laas/HRP2_Batterry_monitor/wiring.png

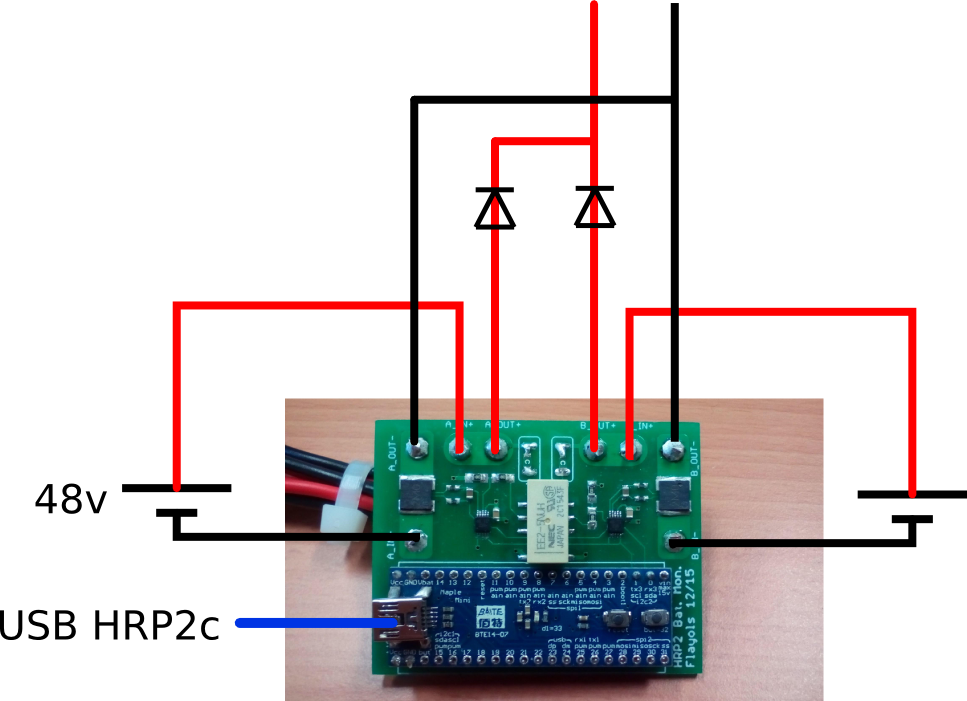
wiring.png
