laas/HRP2_Batterry_monitor/README.md

# HRP2_Battery_monitor
[BOARD] measure voltage and current of each of the 2 batteries of HRP2 via INA226
