laas/HRP2_Batterry_monitor/HARDWARE_HRP2_BATTERY_MONITOR/Battery_monitor_HRP2/Battery_board.brd

## EAGLE design HARDWARE_HRP2_BATTERY_MONITOR/Battery_monitor_HRP2/Battery_board.brd (2016-01-18)

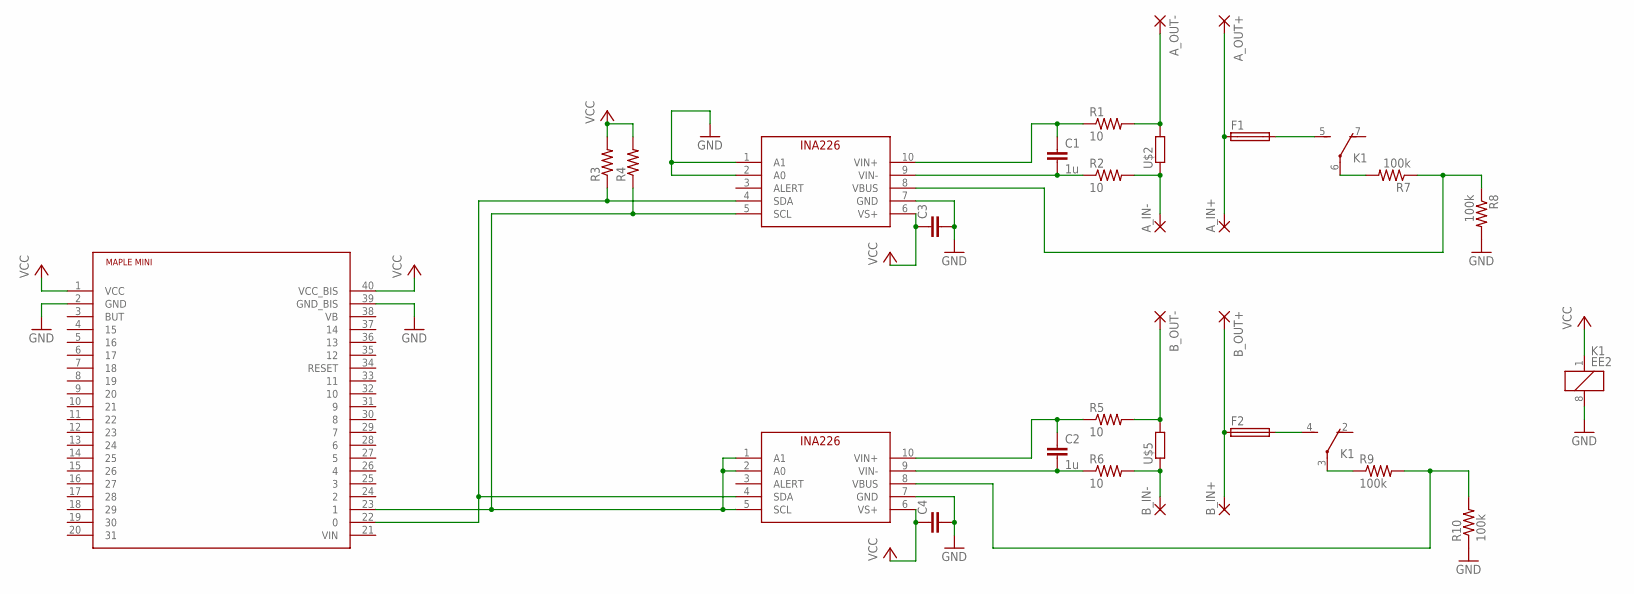
[picture p2: schematic Battery_board.sch]

Parts:
A_IN+: WIREPAD4,16O1,6; 4,16O1,6
A_IN-: WIREPAD4,16O1,6; 4,16O1,6
A_OUT+: WIREPAD4,16O1,6; 4,16O1,6
A_OUT-: WIREPAD4,16O1,6; 4,16O1,6
B_IN+: WIREPAD4,16O1,6; 4,16O1,6
B_IN-: WIREPAD4,16O1,6; 4,16O1,6
B_OUT+: WIREPAD4,16O1,6; 4,16O1,6
B_OUT-: WIREPAD4,16O1,6; 4,16O1,6
C1, C2: 1u; C0603
C3, C4: CC0603; C0603
F1, F2: TE5
K1: EE2; EE2-5NU
R1, R2, R5, R6: 10; R0603
R3, R4: R-US_R0603; R0603
R7, R8, R9, R10: 100k; R1206
U$1, U$4: INA226; MSOP10
U$2, U$5: R_SHUNT_2526; R2526
U$3: MAPLE_MINI; DIL40_MAPLE

Connections:
GND: C3.2, C4.2, K1.8 (2), R8.2, R10.1, U$1.1 (A1), U$1.2 (A0), U$1.7 (GND), U$3.2 (GND), U$3.39 (GND_BIS), U$4.7 (GND)
unnamed: R4.1, U$1.5 (SCL), U$3.23 (1), U$4.1 (A1), U$4.2 (A0), U$4.5 (SCL)
unnamed: C1.1, R1.1, U$1.10 (VIN+)
unnamed: C1.2, R2.1, U$1.9 (VIN-)
unnamed: F1.2, K1.5 (S)
unnamed: A_OUT-.1, R1.2, U$2.2
unnamed: A_IN-.1, R2.2, U$2.1
unnamed: A_IN+.1, A_OUT+.1, F1.1
unnamed: F2.2, K1.4 (S)
unnamed: C2.1, R5.1, U$4.10 (VIN+)
unnamed: C2.2, R6.1, U$4.9 (VIN-)
unnamed: R3.1, U$1.4 (SDA), U$3.22 (0), U$4.4 (SDA)
unnamed: B_OUT-.1, R5.2, U$5.2
unnamed: B_IN-.1, R6.2, U$5.1
unnamed: B_IN+.1, B_OUT+.1, F2.1
unnamed: K1.3, R9.1
unnamed: R9.2, R10.2, U$4.8 (VBUS)
unnamed: K1.6, R7.2
unnamed: R7.1, R8.1, U$1.8 (VBUS)
VCC: C3.1, C4.1, K1.1, R3.2, R4.2, U$1.6 (VS+), U$3.1 (VCC), U$3.40 (VCC_BIS), U$4.6 (VS+)

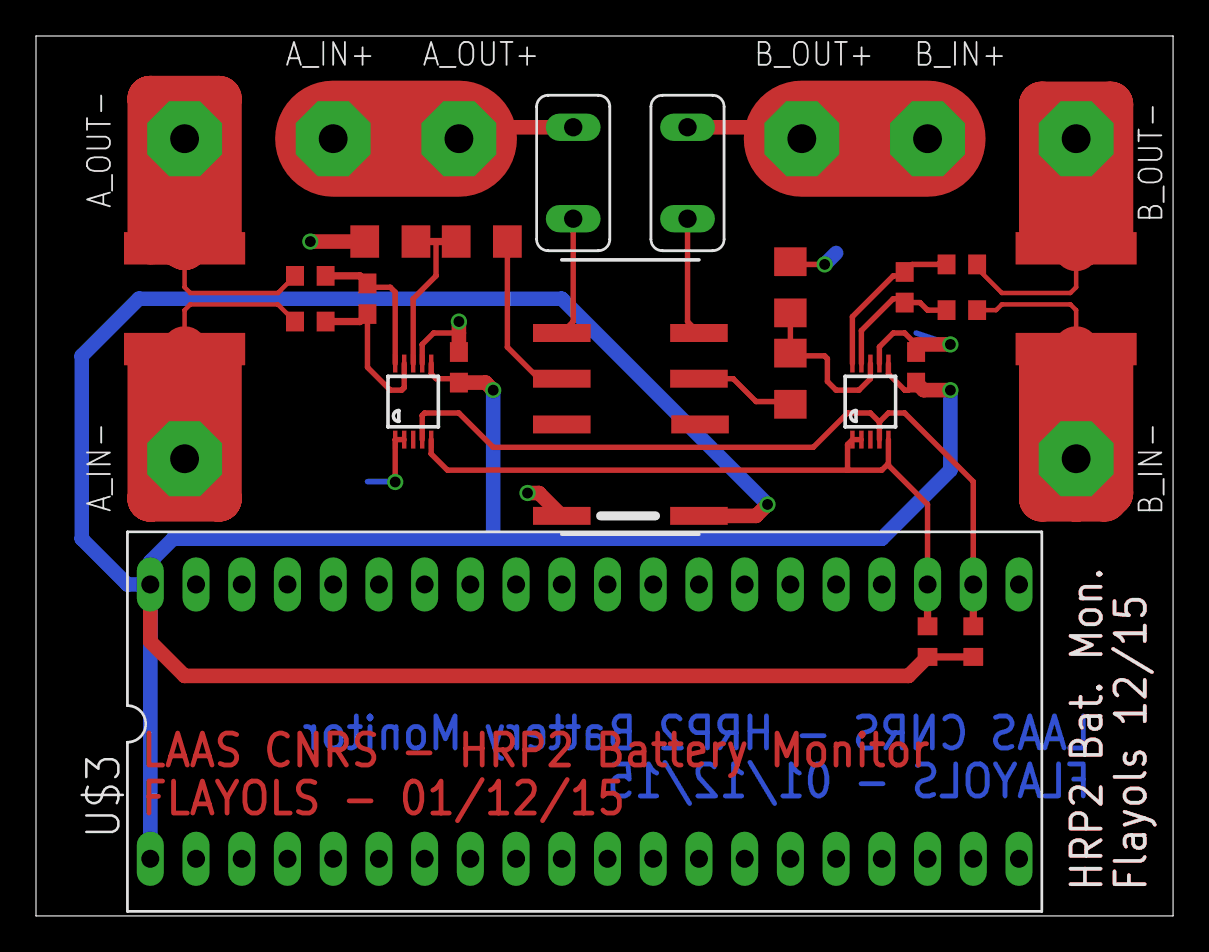
[picture p3: board Battery_board.brd from above]

Board: 2 copper layers, 63.2 x 48.9 mm, 30 parts (0 on the bottom side), 20 nets.
