laas/HRP2_Batterry_monitor/(commit log)

2016-01-11 Add INA226 Library - Read sensor value and send it via USB in readable format
2016-01-18 Add eagle board design files in HARDWARE
    [Battery_board.GBL, Battery_board.GBO, Battery_board.GBP, Battery_board.GBS, Battery_board.GTL, Battery_board.GTO, Battery_board.GTP, Battery_board.GTS]
2016-01-19 AJUST CALIBRATION VALUES - SHOW CURRENT
    Using a resistive charge and measure current and voltage reference given by a mx556 multimeter
    no noise measurement done yet.
    [read_batteries.c]
2016-02-10 add wiring.png
