laas/HRP2_Batterry_monitor/(notices)

Notices in the files:
FIRMWARE_HRP2_BATTERY_MONITOR/INA226.h:
This program is free software: you can redistribute it and/or modify
it under the terms of the version 3 GNU General Public License as
published by the Free Software Foundation.
SOFTWARE_HRP2_BATTERY_MONITOR/log_batteries.c:
it under the terms of the GNU General Public License as published by
the Free Software Foundation; either version 2 of the License, or
(at your option) any later version.
